FFFantasy11/BanlanceCar_github/Core/Src/main.c

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
/* Includes ------------------------------------------------------------------*/
#include "main.h"
#include "i2c.h"
#include "tim.h"
#include "usart.h"
#include "gpio.h"

/* USER CODE BEGIN Includes */
#include "oled.h"
#include "IIC.h"
#include "inv_mpu.h"
#include "inv_mpu_dmp_motion_driver.h"
#include "mpu6050.h"
#include "stdio.h"
#include "sr04.h"
#include "motor.h"
#include "encoder.h"
/* USER CODE END Includes */

/* USER CODE BEGIN PD */
/* ================= 蓝牙遥测（发到电脑上的 VOFA+） =================
   格式叫 FireWater：逗号分隔、换行结尾。VOFA+ 里把解析方式选成 "FireWater"。
   七个通道依次为：
     1 roll 倾角(度)   2 gyrox 角速度(原始值)   3 Vertical_out 直立环输出(PWM)
     4 Velocity_out 速度环输出(度)   5 左右轮脉冲之和   6 stop 摔倒标志
     7 Control_dt_ms 实测控制周期(ms)
   注意 9600 波特率下一帧约 24 字符要占用约 25 ms，发送频率上不去。
   想更快：给蓝牙模块发 AT+BAUD8 改成 115200（改完重新上电），
   再把 usart.c 里的波特率也改成 115200。 */
#define BT_DECIM    5      /* 每 N 次 Control() 发一帧 → 100/N Hz，5 即 20 Hz */
#define BT_OLED_MS  200    /* 屏幕刷新间隔(ms)。故意放慢，因为串口发送是阻塞的 */
/* USER CODE END PD */


/* USER CODE BEGIN PV */
/* 这些变量定义在别的文件（主要是 pid.c），此处声明以便使用 */
extern float roll;
extern float Speed_Pos;
extern float Speed_Pos_Raw;
extern float Control_dt_ms;
extern int Encoder_Left,Encoder_Right;
extern short gyrox;
extern short gyroz;
extern int Vertical_out,Turn_out;
extern float Velocity_out;
extern float Med_Angle;
extern uint8_t stop;
extern volatile uint32_t Control_Tick;
uint8_t display_buf[20];            /* 屏幕显示缓冲 */
uint8_t tx_buf[64];                 /* 串口发送缓冲 */
uint32_t sys_tick;
uint32_t oled_tick;                 /* 上次刷新屏幕的时刻 */
uint32_t bt_tick;                   /* 上次发送遥测的时刻 */
uint32_t bt_ok;                     /* 累计发送成功帧数 */
extern float distance;
extern uint8_t distance_valid;      /* 0 = 上次测距无回波，数据已过期 */
extern uint8_t rx_buf[2];
extern uint8_t Bluetooth_data;      /* 手机 App 最近发来的字节 */
extern uint32_t bt_rx_count;        /* 接收到的字节总数 */
/* USER CODE END PV */

void SystemClock_Config(void);
/* USER CODE BEGIN PFP */
void Read(void);
/* USER CODE END PFP */

/**
  * @brief  The application entry point.
  * @retval int
  */
int main(void)
{
  /* MCU Configuration--------------------------------------------------------*/

  /* Reset of all peripherals, Initializes the Flash interface and the Systick. */
  HAL_Init();

  /* Configure the system clock */
  SystemClock_Config();

  /* Initialize all configured peripherals */
  MX_GPIO_Init();
  MX_I2C1_Init();
  MX_TIM3_Init();
  MX_TIM1_Init();
  MX_TIM2_Init();
  MX_TIM4_Init();
  MX_USART3_UART_Init();
  /* USER CODE BEGIN 2 */
	OLED_Init();
	OLED_Clear();
	MPU_Init();                 /* 初始化 MPU6050 */
	mpu_dmp_init();             /* 加载 DMP 固件，由它内部解算姿态角 */
	OLED_ShowString(0,00,"Init Sucess",16);

	/* 打开 MPU6050 中断：DMP 每算好一组数据就拉低该引脚，
	   中断服务函数里执行一次 Control()，这就是控制节拍的来源。 */
	HAL_NVIC_SetPriority(EXTI9_5_IRQn, 0, 0);
  HAL_NVIC_EnableIRQ(EXTI9_5_IRQn);

	HAL_TIM_PWM_Start(&htim1,TIM_CHANNEL_1);        /* 启动两路电机 PWM */
	HAL_TIM_PWM_Start(&htim1,TIM_CHANNEL_4);
	HAL_TIM_Encoder_Start(&htim2,TIM_CHANNEL_ALL);  /* 启动左右轮编码器 */
	HAL_TIM_Encoder_Start(&htim4,TIM_CHANNEL_ALL);

	/* 打开串口接收中断。手机发来的字节在 USART3_IRQHandler 里
	   被解析成方向指令（见 stm32f1xx_it.c）。 */
	HAL_UART_Receive_IT(&huart3,rx_buf,1);
	Load(0,0);                  /* 先停住电机，避免上电就窜出去 */
	OLED_Clear();
  /* USER CODE END 2 */

  /* Infinite loop */
  /* USER CODE BEGIN WHILE */
  while (1)
  {
		int bt_len;

		/* 每 BT_DECIM 次控制周期发一帧遥测，保证采样间隔均匀 */
		if((uint32_t)(Control_Tick - bt_tick) >= BT_DECIM)
		{
			bt_tick = Control_Tick;
			bt_len = sprintf((char *)tx_buf,"%.2f,%hd,%d,%.2f,%d,%d,%.1f\n",
			                 roll,                        /* 1 倾角(度)      */
			                 gyrox,                       /* 2 角速度(原始值) */
			                 Vertical_out,                /* 3 直立环输出    */
			                 Velocity_out,                /* 4 速度环输出(度) */
			                 Encoder_Left+Encoder_Right,  /* 5 轮速          */
			                 (int)stop,                   /* 6 摔倒标志      */
			                 Control_dt_ms);              /* 7 控制周期(ms)  */
			if(HAL_UART_Transmit(&huart3,tx_buf,(uint16_t)bt_len,100)==HAL_OK)
				bt_ok++;                                 /* 只统计成功帧 */
		}

		/* 屏幕调试信息，刷新较慢，方便不上电脑也能看到状态 */
		if((uint32_t)(HAL_GetTick() - oled_tick) >= BT_OLED_MS)
		{
			oled_tick = HAL_GetTick();
			sprintf((char *)display_buf,"roll:%.1f ",roll);
			OLED_ShowString(0,0,display_buf,16);
			sprintf((char *)display_buf,"distance=%.2f",distance);
			OLED_ShowString(0,2,display_buf,16);
			sprintf((char *)display_buf,"");
			OLED_ShowString(0,4,display_buf,16);

		}
    /* USER CODE END WHILE */

    /* USER CODE BEGIN 3 */
  }
  /* USER CODE END 3 */
}

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
