FFFantasy11/BanlanceCar_github/Core/Inc/encoder.h

/* ============================================================================
 * encoder.h —— 编码器读数接口
 * ==========================================================================*/
#ifndef __ENCODER_H__
#define __ENCODER_H__

#include "stm32f1xx_hal.h"

/* 读出编码器累计脉冲数，读后清零，故返回值代表"上次读取到现在转过的角度"。
 * 有符号，正负对应两个转向。 */
int Read_Speed(TIM_HandleTypeDef *htim);

#endif
