FFFantasy11/BanlanceCar_github/Core/Inc/pid.h

/* ============================================================================
 * pid.h —— 控制模块对外接口
 * ==========================================================================*/
#ifndef __PID_H__
#define __PID_H__

#include "stm32f1xx_hal.h"

/* 执行一次控制计算。由 MPU6050 中断触发，实测每约 8.9 ms 一次（约 112 Hz）。
 * 依次完成：读传感器 → 摔倒保护 → 遥控与避障 → 三个控制环 → 输出电机。 */
void Control(void);

#endif
