FFFantasy11/BanlanceCar_github/Core/Inc/sr04.h

/* ============================================================================
 * sr04.h —— 超声波测距接口（HC-SR04）
 * ==========================================================================*/
#ifndef _SR04_H
#define _SR04_H

#include "stm32f1xx_hal.h"

/* 发出一次测距触发脉冲（约 12 微秒高电平）。
 * 模块会回一个高电平脉冲，宽度正比于距离，由外部中断负责测量。 */
void GET_Distance(void);

#endif
